jvrpapa05/Development-of-Microcontroller-based-Waste-Segregation-Machine/Electronics Design/PCB Layout.PNG

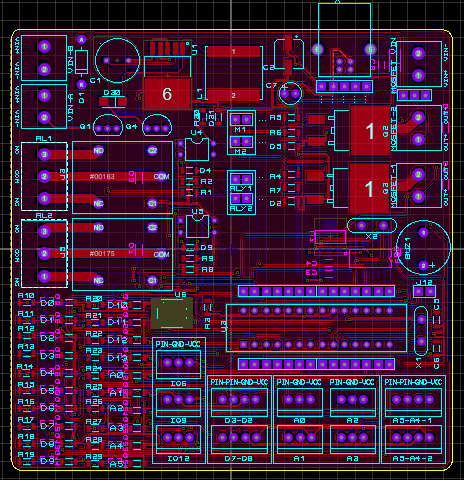
Electronics Design/PCB Layout.PNG
