jvrpapa05/Development-of-Microcontroller-based-Waste-Segregation-Machine/Electronics Design/3D Viewer.PNG

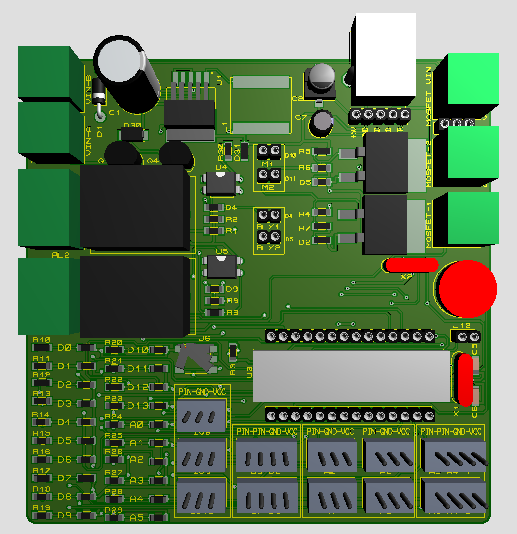
Electronics Design/3D Viewer.PNG
