jvrpapa05/Development-of-Microcontroller-based-Waste-Segregation-Machine/README.md

# Development-of-Microcontroller-based-Waste-Segregation-Machine
