jvrpapa05/Development-of-Microcontroller-based-Waste-Segregation-Machine/Technical Documents/Pin Configuration.xlsx

ATMEGA328P
PIN CONFIGURATION
ATMEL CONFIGURATION |  |  |  |  | HARDWARE CONFIGURATION |  | Notes
PIN | AVR | PROTOCOL | PWM |  | DEVICE | PIN
D0 | PD0 | RX |  |  |  |  |  | `
D1 | PD1 | TX
D2 | PD2 | INT0 |  |  | IR-A | Digital Input | Attach Interrupt Pin
D3 | PD3 | INT1 | ~ |  | IR-B | Digital Input | Attach Interrupt Pin
D4 | PD4 |  |  | RLY 1
D5 | PD5 |  | ~ | RLY 2
D6 | PD6 |  | ~
D7 | PD7 |  |  |  | Stepper DIR | Digital Output | CC & CW Direction
D8 | PB0 |  |  |  | Stepper PUL | Digital Output | Pulses to Move
D9 | PB1 |  | ~ |  | Servo Lid | PWM Output
D10 | PB2 |  | ~ | MFT 1 | Solenoid Lock | Digital Output
D11 | PB3 | MOSI | ~ | MFT 2
D12 | PB4 | MISO |  |  | E18-D80NK | Digital Input
D13 | PB5 | SCK |  |  | Buzzer | Digital Output
A0 | PC0 |  |  |  | Button CAL | Digital Input | Calibrate Stepper Shaft
A1 | PC1 |  |  |  | Button RST | Digital Input | Test Direction Movement
A2 | PC2 |  |  |  | Metal RESET | Digital Output
A3 | PC3 |  |  |  | Metal DETECT | Digital Input
A4 | PC4 | SDA |  |  | 20x4 I2C LCD | SDA
A5 | PC5 | SCL |  |  | 20x4 I2C LCD | SCL
A6
A7
