jvrpapa05/Development-of-Microcontroller-based-Waste-Segregation-Machine/3D Design/Whole Assembly.SLDASM

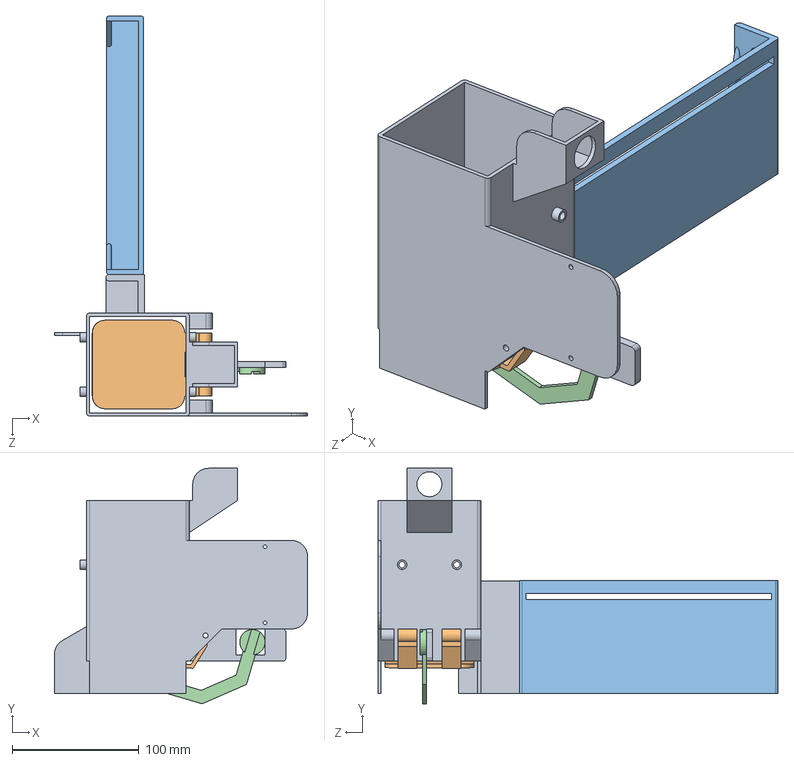
[picture p3: CAD file, 2021-04-18]
3D Design/Whole Assembly.SLDASM
200.0 x 186.0 x 315.8 mm
Segregator v4.1
Lever v5.1
Holder v1.0
Pusher
