jvrpapa05/Development-of-Microcontroller-based-Waste-Segregation-Machine/3D Design/Segregator v4.1.SLDPRT

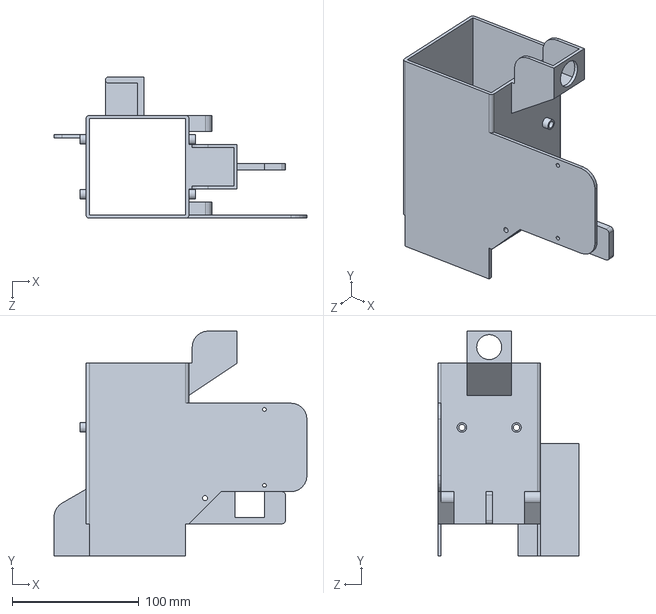
[picture p4: CAD file, 2021-04-18]
3D Design/Segregator v4.1.SLDPRT
200.0 x 177.8 x 111.8 mm
