jvrpapa05/Development-of-Microcontroller-based-Waste-Segregation-Machine/3D Design/StepperKey.SLDPRT

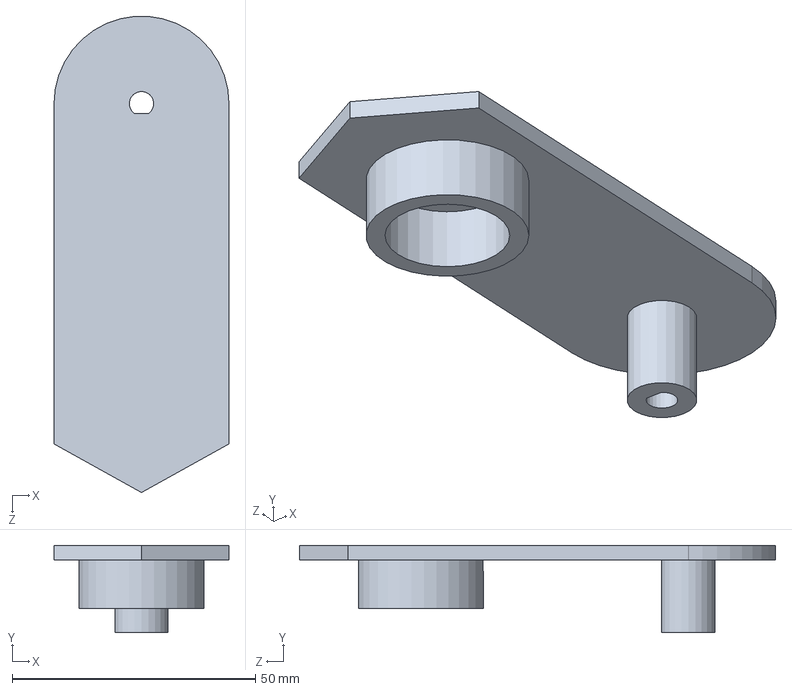
[picture p5: CAD file, 2021-04-18]
3D Design/StepperKey.SLDPRT
36.0 x 18.0 x 97.9 mm
