jvrpapa05/Development-of-Microcontroller-based-Waste-Segregation-Machine/3D Design/Pusher.SLDPRT

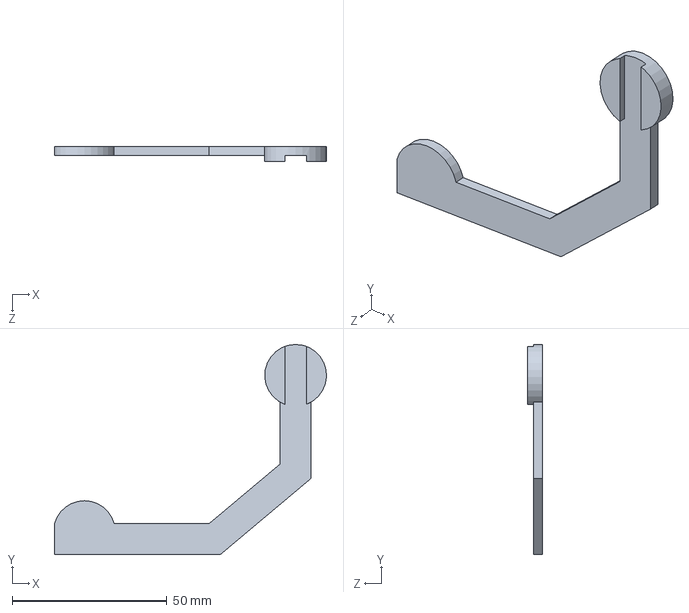
[picture p6: CAD file, 2021-04-18]
3D Design/Pusher.SLDPRT
88.0 x 67.9 x 5.00 mm
