jvrpapa05/Development-of-Microcontroller-based-Waste-Segregation-Machine/3D Design/Holder v1.0.SLDPRT

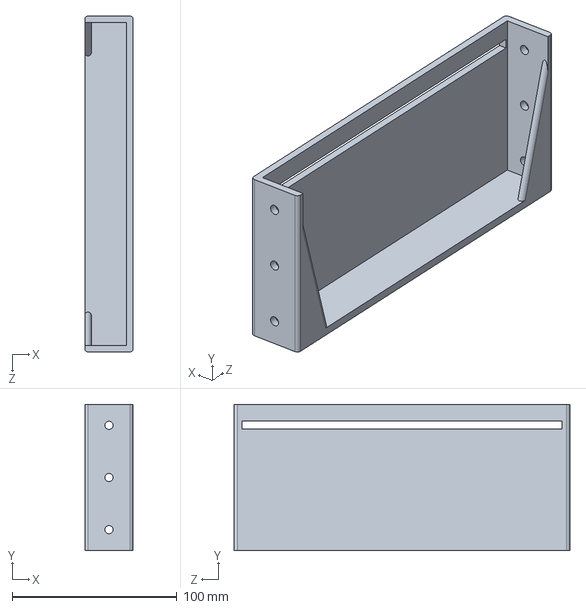
[picture p7: CAD file, 2021-04-18]
3D Design/Holder v1.0.SLDPRT
29.4 x 88.9 x 204.0 mm
