jvrpapa05/Development-of-Microcontroller-based-Waste-Segregation-Machine/3D Design/Lever v5.1.SLDPRT

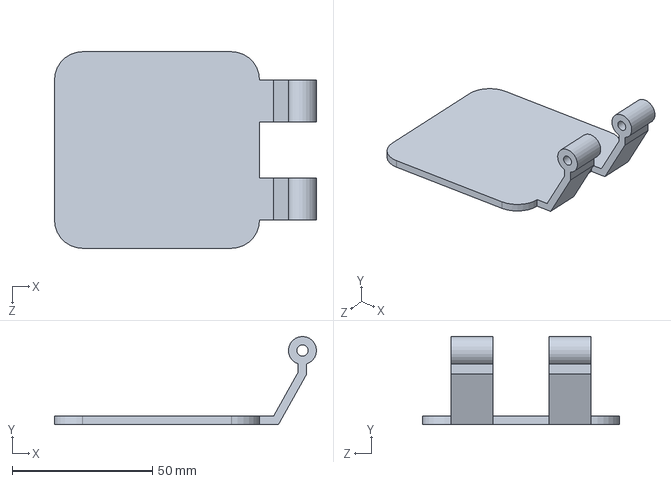
[picture p8: CAD file, 2021-04-18]
3D Design/Lever v5.1.SLDPRT
93.3 x 31.4 x 70.0 mm
