jvrpapa05/Development-of-Microcontroller-based-Waste-Segregation-Machine/3D Design/Lever v5.0.SLDPRT

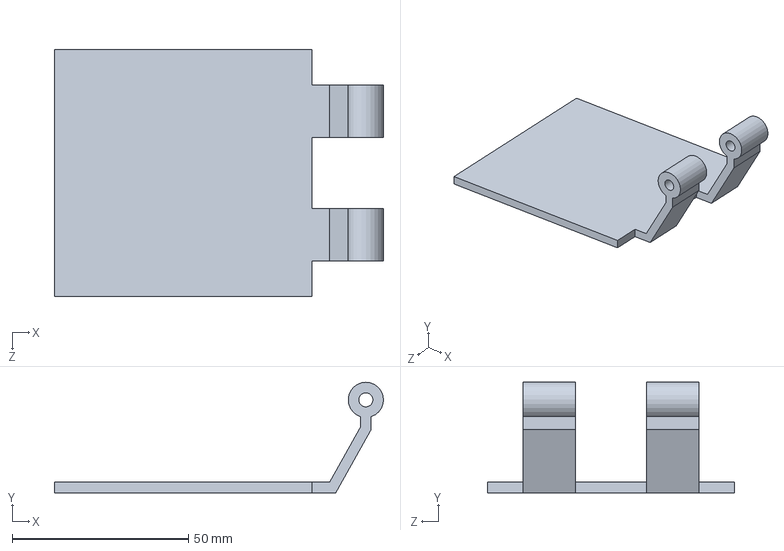
[picture p9: CAD file, 2021-04-18, an earlier design]
3D Design/Lever v5.0.SLDPRT
93.3 x 31.4 x 70.0 mm
