jvrpapa05/Development-of-Microcontroller-based-Waste-Segregation-Machine/3D Design/Segregator v3.0.SLDPRT

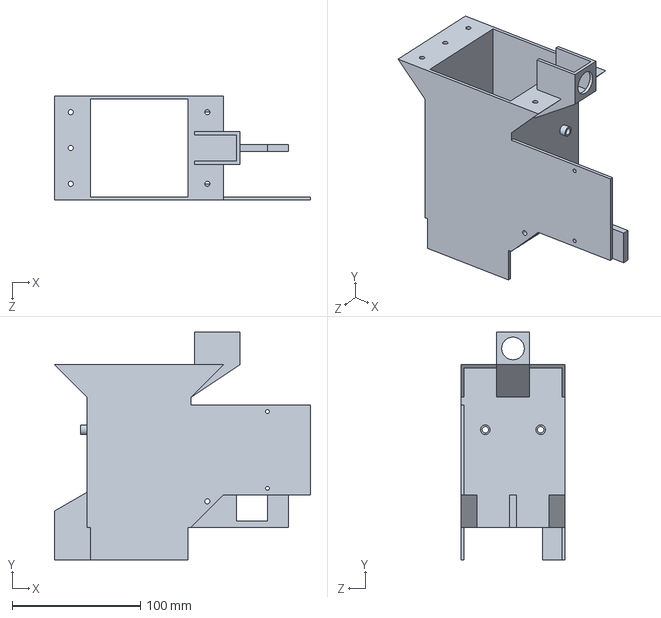
[picture p10: CAD file, 2021-04-18, an earlier design]
3D Design/Segregator v3.0.SLDPRT
200.0 x 177.8 x 81.3 mm
