jvrpapa05/Development-of-Microcontroller-based-Waste-Segregation-Machine/3D Design/Lever v4.1.SLDPRT

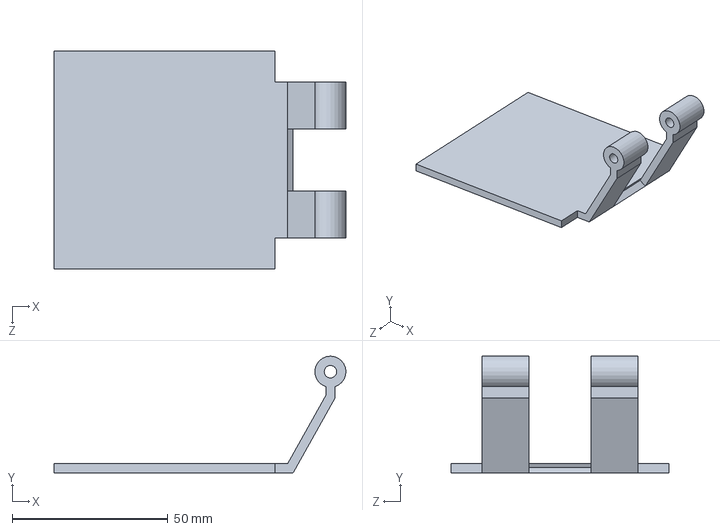
[picture p11: CAD file, 2021-04-18, an earlier design]
3D Design/Lever v4.1.SLDPRT
93.7 x 37.5 x 70.0 mm
