jvrpapa05/Development-of-Microcontroller-based-Waste-Segregation-Machine/(list of files, cad)

Other CAD files:
3D Design/Segregator v4.0.SLDPRT
3D Design/Segregator v3.1.SLDPRT
3D Design/Pusher.SLDDRW
3D Design/Segregator v2.1.SLDDRW
3D Design/Segregator v3.0.SLDDRW
3D Design/Segregator v4.1.SLDDRW
3D Design/Whole Assembly.SLDDRW
