jvrpapa05/Development-of-Microcontroller-based-Waste-Segregation-Machine/Electronics Design/Main_System.pdf

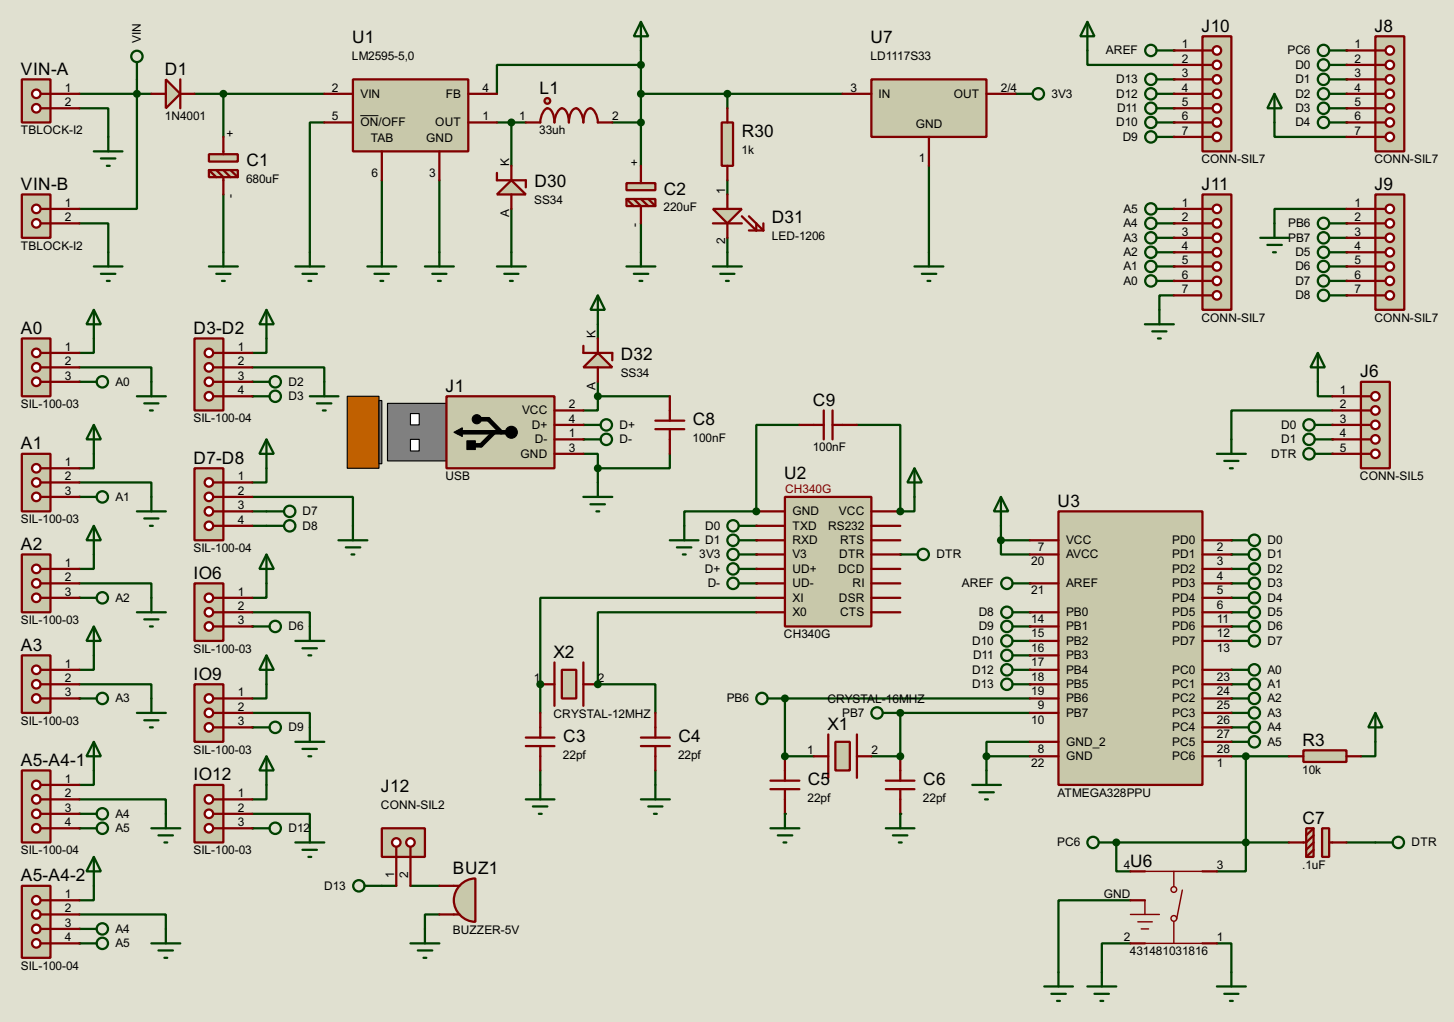
[picture p12: page 1]

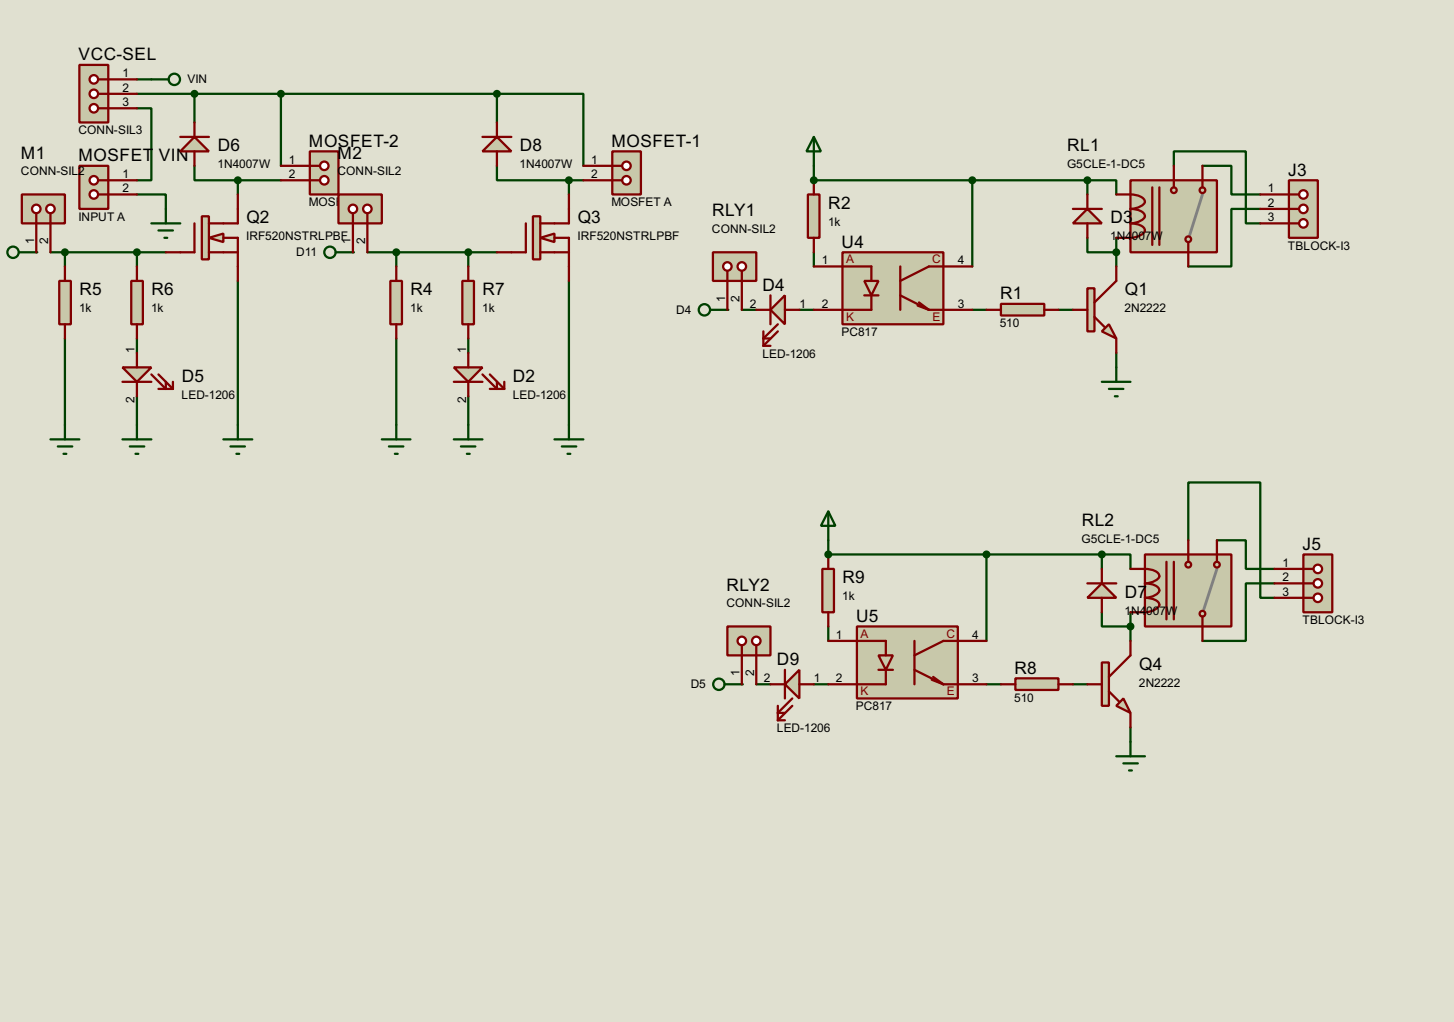
[picture p13: page 2]

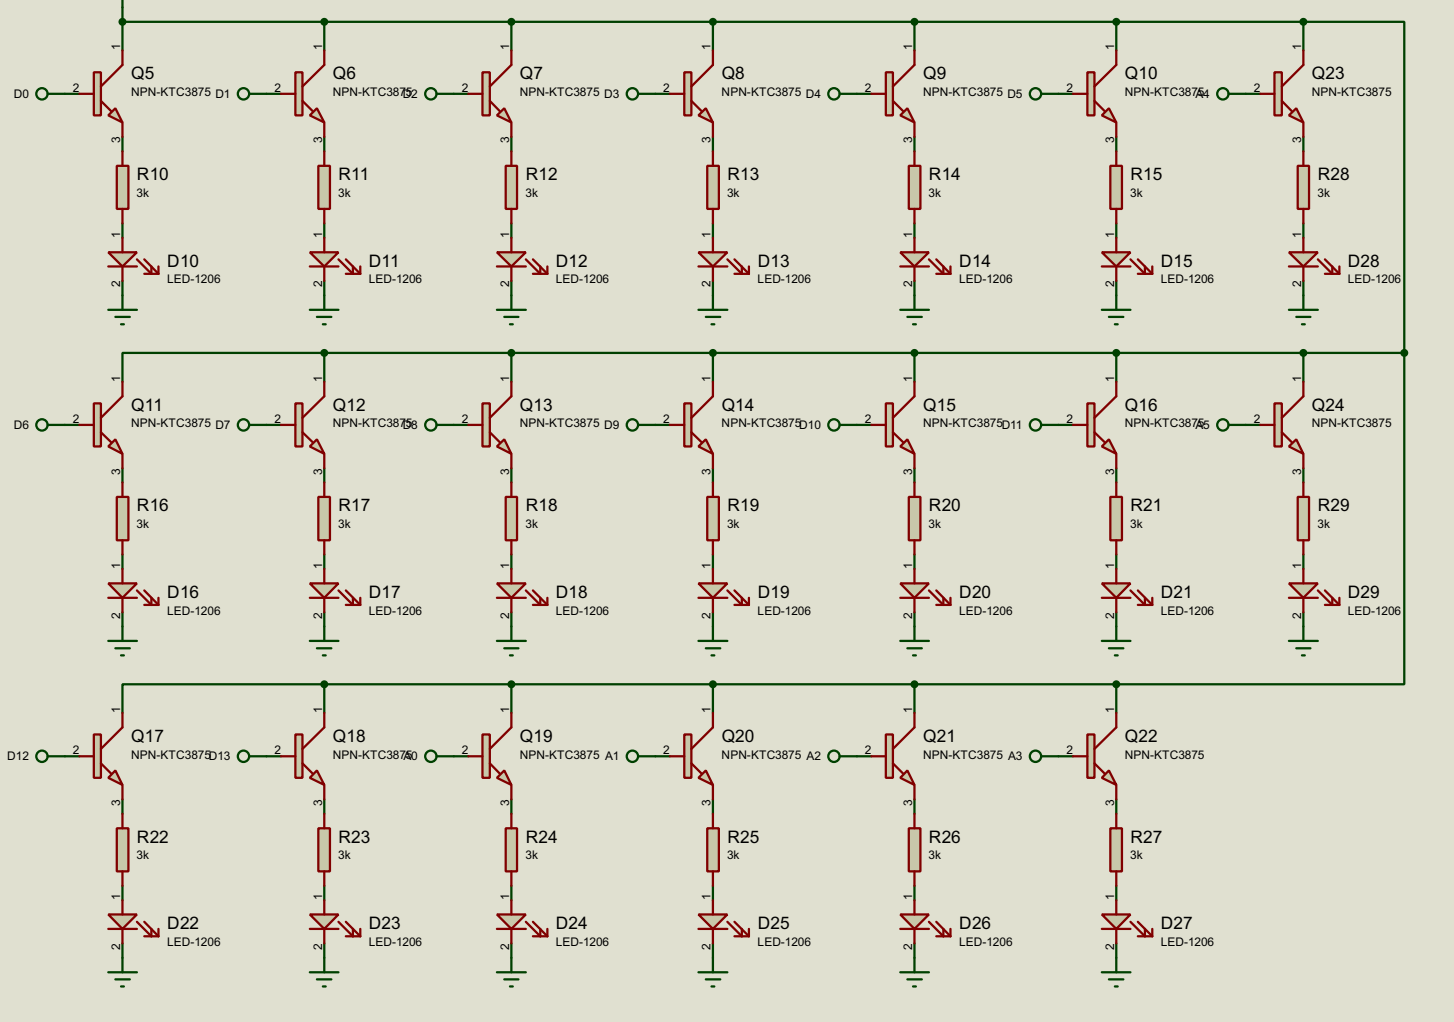
[picture p14: page 3]
